djdefi/traincam-ncngrr/ansible/roles/trainview/files/visitor/donate-qr.png

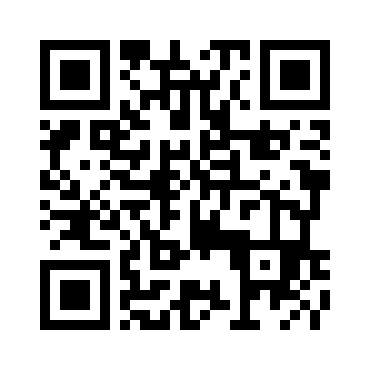
ansible/roles/trainview/files/visitor/donate-qr.png
