djdefi/traincam-ncngrr/ansible/roles/trainview/files/visitor/engine.jpg

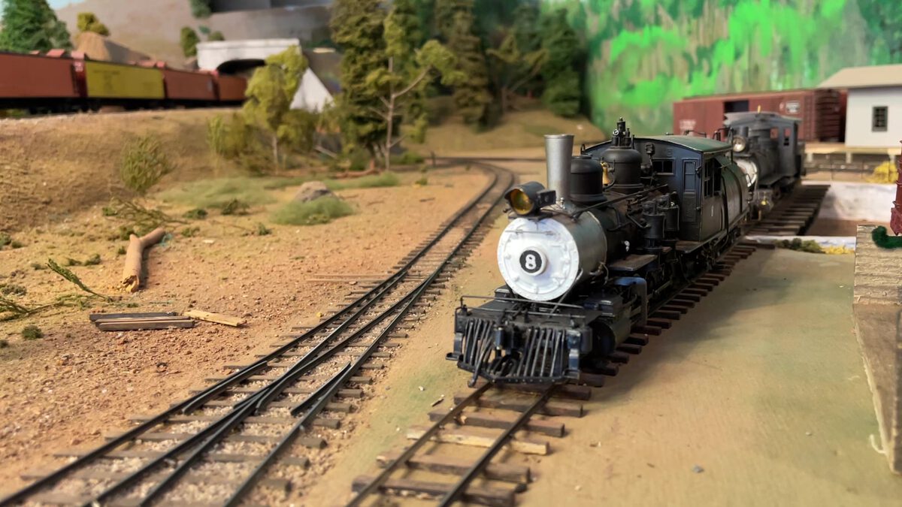
ansible/roles/trainview/files/visitor/engine.jpg
