djdefi/traincam-ncngrr/ansible/roles/trainview/files/visitor/layout.jpg

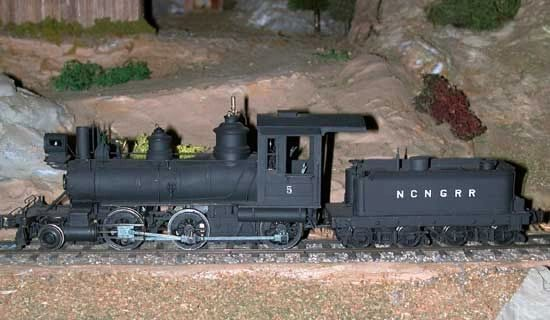
ansible/roles/trainview/files/visitor/layout.jpg
