djdefi/traincam-ncngrr/ansible/roles/trainview/files/visitor/map-qr.png

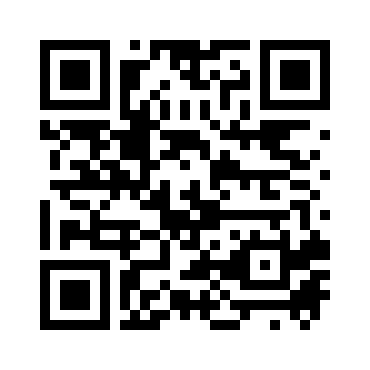
ansible/roles/trainview/files/visitor/map-qr.png
