djdefi/traincam-ncngrr/ansible/roles/trainview/files/visitor/trestle.jpg

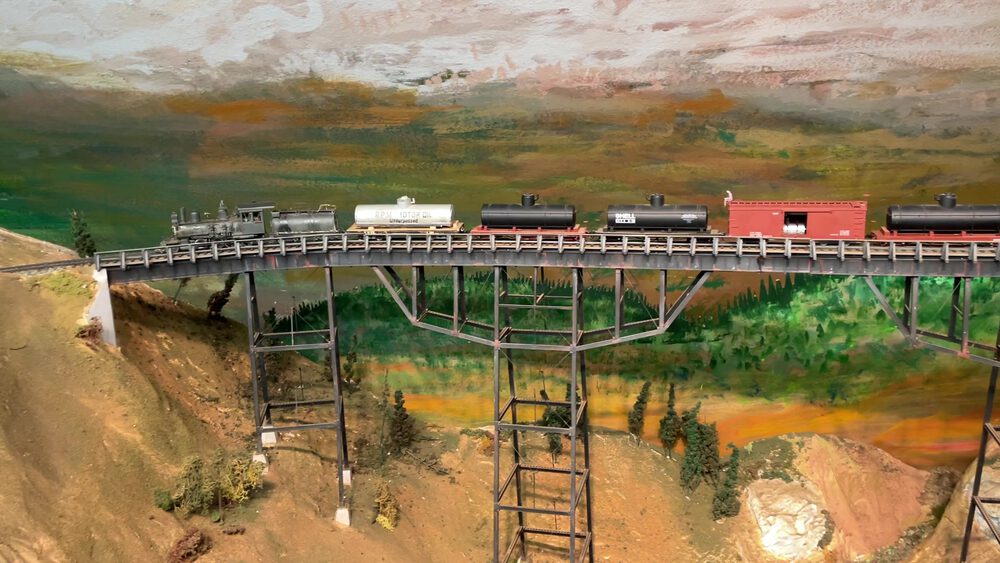
ansible/roles/trainview/files/visitor/trestle.jpg
