djdefi/traincam-ncngrr/ansible/roles/trainview/files/visitor/volunteer-qr.png

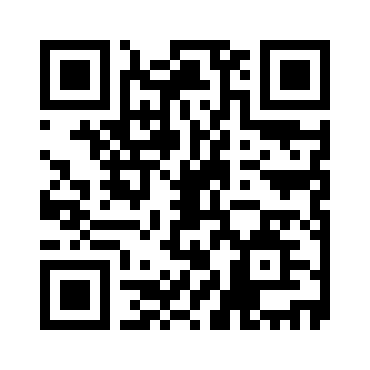
ansible/roles/trainview/files/visitor/volunteer-qr.png
