djdefi/traincam-ncngrr/ansible/roles/trainview/files/visitor/website-qr.png

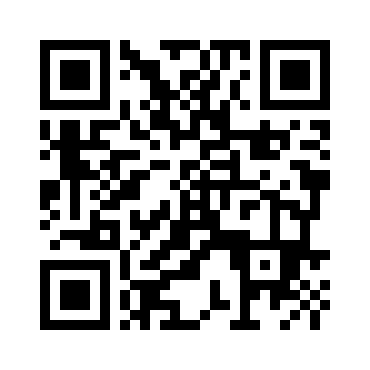
ansible/roles/trainview/files/visitor/website-qr.png
