djdefi/traincam-ncngrr/ios/screenshots/01_camera_list.png

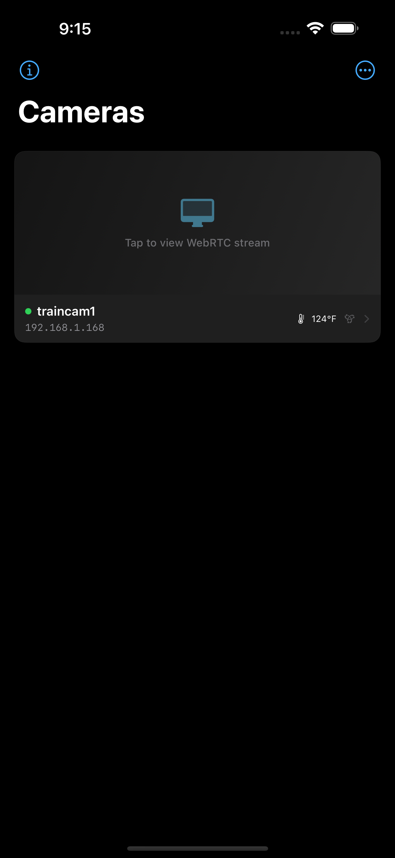
ios/screenshots/01_camera_list.png
