djdefi/traincam-ncngrr/ios/screenshots/02_about.png

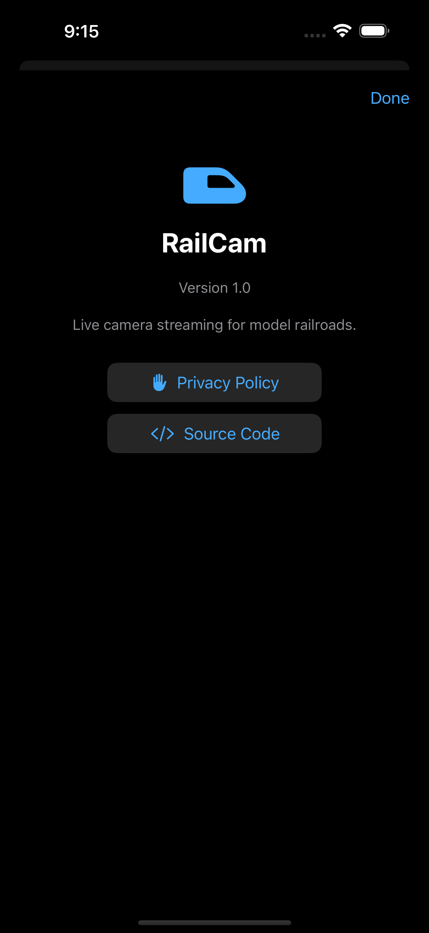
ios/screenshots/02_about.png
