djdefi/traincam-ncngrr/ios/screenshots/03_camera_detail.png

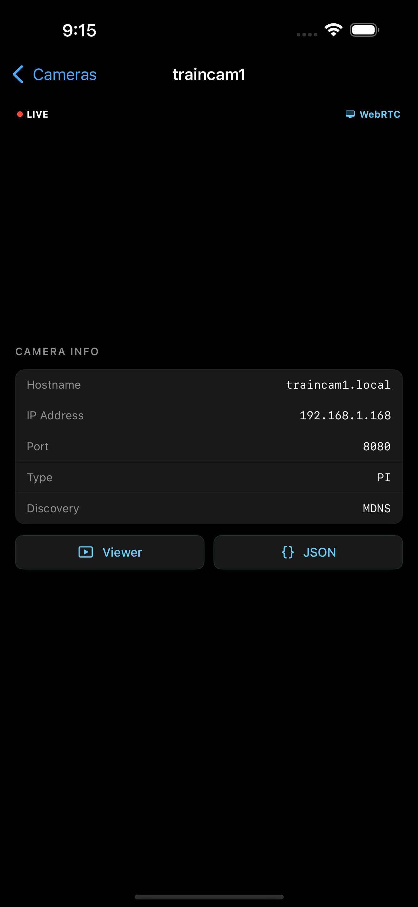
ios/screenshots/03_camera_detail.png
