djdefi/traincam-ncngrr/issues/1.md

### Feature Request: Add mDNS (Bonjour/zeroconf) Service Discovery to ESP32 Camera Server

**Status:** Implemented. Each module advertises `_traincam._tcp` and uses a unique `traincam-xxxxxx.local` hostname.

#### Summary
This issue requests the addition of mDNS (Bonjour/zeroconf) service discovery to the ESP32 camera server.

#### Implementation Details
1. **Initialize mDNS in setup()**: Modify the setup function to initialize mDNS.
2. **Advertise HTTP Service**: Ensure that the HTTP service is advertised over mDNS.
3. **Documentation**: Include brief documentation in the code to guide users on how to utilize this feature.
4. **Reference File**: The implementation can be referenced in the file `camunit/espcameraserver.ino`.

This addition will greatly enhance the usability and accessibility of the ESP32 camera server.
