djdefi/traincam-ncngrr/CameraWebServer/camera_index.h

//File: minimal_index.html.gz, Size: 405
#define index_ov2640_html_gz_len 405
const uint8_t index_ov2640_html_gz[] = {
  0x1f, 0x8b, 0x08, 0x08, 0xc2, 0x61, 0x81, 0x68, 0x00, 0x03, 0x6d, 0x69,
  0x6e, 0x69, 0x6d, 0x61, 0x6c, 0x5f, 0x69, 0x6e, 0x64, 0x65, 0x78, 0x2e,
  0x68, 0x74, 0x6d, 0x6c, 0x00, 0x85, 0x52, 0xcb, 0x6e, 0xc2, 0x30, 0x10,
  0xbc, 0xe7, 0x2b, 0x5c, 0xa3, 0x0a, 0x7a, 0x80, 0x24, 0x54, 0xa5, 0x55,
  0x1e, 0x48, 0x15, 0xa5, 0xd7, 0xa2, 0xd2, 0x4b, 0x4f, 0x95, 0xe3, 0x47,
  0x62, 0xe1, 0xd8, 0x91, 0xed, 0x14, 0x10, 0xe2, 0xdf, 0xeb, 0x90, 0x84,
  0x42, 0x2f, 0x55, 0x0e, 0x23, 0x7b, 0x77, 0x66, 0x77, 0xc6, 0x49, 0x6e,
  0x5e, 0xde, 0x16, 0x1f, 0x9f, 0xab, 0x25, 0x28, 0x6c, 0x29, 0xe6, 0x5e,
  0xd2, 0x03, 0x45, 0xc4, 0x81, 0xe5, 0x56, 0xd0, 0xf9, 0x72, 0xbd, 0xba,
  0x9f, 0x82, 0x05, 0x2a, 0xa9, 0x46, 0x89, 0xdf, 0xde, 0x79, 0x89, 0xb1,
  0xfb, 0x06, 0x33, 0x45, 0xf6, 0x07, 0xa6, 0xa4, 0x1d, 0x33, 0x54, 0x72,
  0xb1, 0x8f, 0x9e, 0x35, 0x47, 0x22, 0x2e, 0x91, 0xce, 0xb9, 0x8c, 0xa6,
  0x41, 0xb5, 0x8b, 0x33, 0x84, 0x37, 0xb9, 0x56, 0xb5, 0x24, 0xd1, 0x80,
  0x05, 0xcd, 0x77, 0xf4, 0x26, 0xd8, 0x51, 0x10, 0x97, 0x54, 0x1f, 0x4a,
  0xb4, 0x1b, 0x6f, 0x39, 0xb1, 0x45, 0x34, 0x0b, 0x9a, 0xf6, 0x8e, 0x1a,
  0x00, 0x54, 0x5b, 0x75, 0x49, 0xde, 0x16, 0xdc, 0xd2, 0xb8, 0x42, 0x84,
  0x70, 0x99, 0x77, 0xd2, 0x4a, 0x13, 0xaa, 0xc7, 0x1a, 0x11, 0x5e, 0x9b,
  0x28, 0x74, 0x57, 0x47, 0x6f, 0x60, 0xac, 0xa6, 0xa8, 0xbc, 0xd0, 0x0d,
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
  0xc4, 0x6f, 0x79, 0xff, 0x08, 0x30, 0x6a, 0x71, 0x31, 0x1a, 0xfa, 0xcc,
  0x15, 0x8b, 0x2f, 0xab, 0xf2, 0x5c, 0xd0, 0xa1, 0x53, 0x79, 0x6d, 0xce,
  0x17, 0x1a, 0x7e, 0xbb, 0x4b, 0x0f, 0x9d, 0x6b, 0xbf, 0xfd, 0xdd, 0x7e,
  0x00, 0x0c, 0x25, 0x39, 0xb4, 0x86, 0x02, 0x00, 0x00
};
