djdefi/traincam-ncngrr/(commit log)

2025-07-16 Open issue requesting mDNS service discovery for ESP32 camera server.
2025-07-21 add cam server
    [partitions.csv]
2026-01-31 Add Ansible playbooks, docs, and test suite for TrainCam
    - Ansible role for Pi deployment (traincam, mediamtx, viewer services)
    - Multi-level architecture docs (simple → contributor)
    - Hardware power chain documentation (DCC → camera)
    - Network/mDNS configuration docs
    - Demo quick reference for meetups
    - Test suite (38 tests for latency, config, network)
    - Scaling guide for multiple cameras
    - WiFi credential management tracked as issue #2
    Viewer URL: http://traincam1.local:8080/viewer.html
    [partitions.csv]
2026-02-01 Production readiness: DRY config, OSS files, CI
    - Add LICENSE (MIT), CONTRIBUTING.md, CODE_OF_CONDUCT.md
    - Add .gitignore for common artifacts
    - Add GitHub Actions CI workflow (lint + test)
    - Add issue/PR templates
    - Consolidate group_vars (remove duplicate ansible/group_vars)
    - Centralize all port numbers in group_vars/traincam.yml
    - Use variables for ports in mediamtx.yml.j2 and tasks
    [main.yml, traincam.yml]
2026-02-12 Add iOS app (RailCam) with App Store submission pipeline
    - iOS app: SwiftUI camera viewer for TrainCam streams (MJPEG + WebRTC)
    - Auto-discovery via mDNS and Bluetooth LE
    - 19 unit tests + 8 UI tests
    - Fastlane automation for App Store Connect
    - Privacy policy, metadata, screenshots
    - App Store display name: RailCam (bundle: com.railcam.app)
2026-02-12 Update app icon: camera lens design
2026-02-12 v1.1: Reliability fixes, onboarding, and settings
    P0 Bug fixes:
    - Persist manually added cameras to UserDefaults
    - WebRTC stream error handling with retry button
    - Telemetry unavailable state UI
    - Fix TelemetryFetcher timer retain cycle
    P1 UX improvements:
    - First-launch onboarding (3-page swipeable guide)
    - Stream health indicator (detect stalled MJPEG streams)
    - Auto-detect camera type for manual IP entry
    - Settings screen (timeout, temp unit, about/privacy links)
2026-02-12 DRY refactor + expand test coverage to 38 tests
    Refactoring:
    - Extract Theme.swift: shared Color.appAccent, .cardBackground, .sectionBackground
    - Extract AppURL constants for privacy policy and source code links
    - Fix force-unwrapped URLs in SettingsView
    - Standardize error messages to 'Stream unavailable'
    New tests (19 added, 38 total):
    - CameraPersistenceTests: Codable roundtrip, UserDefaults storage
    - CameraDiscoveryTests: add/remove/dedupe/sort manual cameras
    - StreamHealthTests: stall detection, error state, lifecycle
2026-02-12 App Store review prep: vibrant icon, strip debug logging, fix placeholders
    - New app icon: bright teal, white camera, clean professional design
    - Wrap all print() in #if DEBUG
    - Fix App Store rating URL (real app ID 6759075304)
    - Add Reset App Data option in Settings (Apple data deletion requirement)
    - Replace emoji with SF Symbol in onboarding
2026-07-28 Prepare TrainCam for fair operation
    Replace the untracked multi-camera viewer with a reproducible single-feed deployment, harden Pi service recovery and mDNS, and prepare the ESP32 firmware for zero-touch discovery.
    Copilot-Session: dcab7405-f2e7-4d6c-9f27-47ca47327750
    [CameraWebServer.ino, app_httpd.cpp, main.yml, traincam.yml]
2026-07-28 Reduce camera Pi power draw
    Run the camera as a strict headless appliance, disable unused hardware and services, and remove a NetworkManager override rejected by the installed version. Preserve WiFi and all video settings.
    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
2026-07-28 Use the NoIR tuning file for the camera module
    The camera has no IR-cut filter, but libcamera was loading the stock
    ov5647.json, which renders the whole scene magenta. Measured on the live
    stream against a neutral 128: U 143.3 / V 148.4 before, 123.9 / 124.8
    after, with luma unchanged at ~97 — it is purely the colour matrix, no
    exposure or noise cost.
    TUNING_FILE is a variable rather than a hardcoded path because an
    IR-filtered module needs the stock tuning instead. A path that does not
    exist warns and falls back to the libcamera default; a colour problem
    should not take the camera offline.
    tests/test_config_parsing.sh evaluates the selection block straight out
    of publish.sh.j2 so the fa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
    [traincam.yml]
2026-07-28 Shorten the AGC shutter ladder so motion stays sharp
    The stock ov5647 tuning is built for stills: exposure_modes.normal walks
    shutter to 30000us before analogue gain passes 4, so a camera bolted to a
    moving train parks at 1/33s and smears everything. Measured 30897us at
    ISO 400 in a daylit office.
    --exposure sport is meant to fix exactly this, but libcamera 0.5.1 ignores
    it -- normal, sport and long all returned 29986us at gain 3.31 on this
    build. (--ev -2 did move it, so the control path itself is live.) That
    leaves patching the ladder in the tuning file as the only route.
    The new ladder spends gain earlier: 15821us at gain 6.00 where stock gave
    29986us at gain 3.06, same scene, same Lux.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
    [main.yml, traincam.yml]
2026-07-28 Reset the Pi from a kernel hang without touching the train
    The camera Pi froze on the bench today: solid ACT LED, no network, dead for
    20+ minutes until power-cycled by hand. Restart=always cannot help here --
    a hung kernel takes systemd with it, so nothing was left running to do the
    restarting. In a train car on a layout that means pulling the car off the
    track mid-show.
    The BCM2835 has a watchdog and systemd can drive it. 14s is not a tuning
    choice: max_hw_heartbeat_ms is WDOG_TICKS_TO_MSECS(PM_WDOG_TIME_SET) =
    0xfffff >> 16 = 15s (drivers/watchdog/bcm2835_wdt.c:29,161-162, rpi-6.12.y,
    matching the 6.12.25 kernel on the Pi). Anything above 15 is silently
    accepted by systemd and then never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
    [main.yml, traincam.yml]
2026-07-28 Recover the camera when the WiFi chip wedges
    The Pi went unreachable three times today and I blamed the battery. The
    persistent journal from 9b6ecdd shows otherwise: it kept logging right up to
    the moment the power was pulled. The Pi was healthy the whole time. Only the
    WiFi was gone.
    21:16:33 brcmf_sdio_txfail: sdio error, abort command and terminate frame
    21:16:34 brcmf_sdio_readframes: RXHEADER FAILED: -110
    21:16:34 brcmf_sdio_isr: failed backplane access
    The SDIO bus to the BCM43430 times out under sustained TX. brcmf_sdio_dpc()
    halts, but only marks the bus down on -ENOMEDIUM, and this is -ETIMEDOUT, so
    it never does. Two consequences shaped this change:
    - wlan0 still reports o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
    [main.yml, traincam.yml]
2026-07-28 Back off and jitter viewer reconnects instead of hammering
    Explains the "143 WHEP sessions in 5 minutes" from the Jul 28 outage, which
    was open in the plan as unexplained. It was not several clients. The journal
    shows every one of those sessions created by the same address AND the same
    source port, 1.57-1.63s apart - AUTOREC_DELAY_MS plus a round trip. One
    browser tab, retrying on a fixed timer while the SDIO radio was already
    failing. MediaMTX holds each dead attempt ~10s before reaping it, so roughly
    six stale sessions existed at any moment, all of them costing server state
    and TX during the exact window the radio could least afford it.
    So: double the delay on each failure, cap at 15s, re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
2026-07-29 Stop spending 38% of the bitrate on keyframes
    ultra_plus means --intra 6, which at 24fps is four keyframes a second. With
    the 2500kbps cap from 6aad60c that turned out to be crippling. Measured on
    the live stream with ffprobe, 8s windows:
    intra 6 38.2% of all bits on keyframes, P avg 9756 B, 2.53 Mbps
    intra 24 17.3%, P avg 11239 B, 2.48 Mbps
    intra 48 11.5%, P avg 11810 B, 2.25 Mbps
    An I-frame averages 28161 B against a P-frame's 10022, so four a second was
    eating the budget that should have been buying picture detail. Switching to
    `low` (intra 24) gives ~15% more bits per P-frame at the same bitrate.
    Confirmed live afterwards: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
2026-07-29 Let the deploy name a camera sensor overlay
    camera_auto_detect=1 only probes the official Raspberry Pi sensors - ov5647,
    imx219, imx477, imx708. Arducam's own boards are not in that list, so an
    Arducam 16MP (imx519) or 64MP (ov64a40) stays completely invisible until the
    overlay is named explicitly, and the symptom is indistinguishable from a dead
    ribbon cable. The on-device overlays README is explicit that these are manual:
    "Load: dtoverlay=imx519,<param>=<val>". This Pi already ships the .dtbo files
    for imx519, ov64a40, imx462/290/327/335/415, imx296, imx477 and imx708.
    Hand-editing /boot/firmware/config.txt is not an option because this role
    manages that file - the next deploy would silen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
2026-07-29 Document why the picture is soft, and how to swap the module
    Two things cost real time this week and neither was written down.
    The fitted OV5647 is a NoIR. 388f808 already fixed the colour matrix for it,
    so the remaining "blurry and washed out" reads like a bitrate or focus
    problem - it is neither. IR floods every photosite (washed out) and focuses
    at a different plane than visible light, landing defocused on top of the
    sharp image (soft). No config setting fixes either; the module is simply the
    wrong part for a lit layout. Added the remote-control trick for telling a
    NoIR from a filtered module, which needs no tools.
    Second, camera_auto_detect probes ONLY ov5647/imx219/imx477/imx708. Ever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
2026-07-29 Patch the AGC ladder on channels[] tuning files too
    The shutter-first AGC ladder from 2cc3555 was only being applied to
    tuning files that put exposure_modes directly in rpi.agc. That is the
    ov5647's schema and nothing else's: imx219, imx477 and imx708 all nest
    one copy per HDR channel under rpi.agc.channels[].
    So fitting an imx219 silently reverted the ladder to stock -
    shutter [100, 10000, 30000, 60000, 66666]
    which parks at 30000us before it will raise gain past 4. That is exactly
    the 1/33s motion smear the ladder exists to prevent, on a camera bolted
    to a moving train. The script did warn on stderr, but a deploy prints
    enough that nobody would have seen it.
    Patches every channel. Th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
2026-07-29 Run the IMX219 module, full FOV, with matching tuning
    The Arducam/"OMP camera v2.3" that "was never detected" is fine. It was
    never a hardware fault: camera_auto_detect only probes the four official
    Raspberry Pi sensors and fails on anything else - including clones of
    those four - in a way indistinguishable from a dead ribbon cable. Named
    explicitly it enumerates first try:
    0 : imx219 [3280x2464 10-bit] (/base/soc/i2c0mux/i2c@1/imx219@10)
    Three changes, each measured on the device:
    camera_auto_detect now follows the overlay. The two must not both run,
    since auto_detect appends its own dtoverlay for whatever it finds. This
    is also what keeps the rollback to one line: clear the overlay an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
    [main.yml, traincam.yml]
2026-07-29 Document the camera swap, and correct the cable advice
    Three fixes to what was written before the module was actually swapped:
    The cable step said to keep the ribbon that works today. That is wrong
    and would have wasted an evening: the Pi Zero end is narrow 22-pin, but
    the module end varies, and the OV5647 here uses narrow->wide 15-pin,
    which physically cannot fit a module with a 22-pin socket. A mismatched
    cable is itself a plausible reason a module "was never detected".
    The NoIR section described the fitted module in the present tense. It is
    no longer fitted. Marked resolved rather than deleted - the symptoms are
    distinctive and worth recognising - and added the reverse case, since
    using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
2026-07-29 Lock AWB gains; retract the "IR-filtered" claim from 5ce4a47
    5ce4a47 said this imx219 is IR-filtered and shipped imx219.json. That was
    wrong, and it was wrong because I judged it by eye from rpicam-jpeg stills.
    Two errors, both caught only by measuring:
    1. THE STILL PATH LIES ABOUT THE VIDEO PATH. rpicam-jpeg and rpicam-vid with
    byte-identical options measured 1.046/1.032 vs 0.785/0.809 on the same
    scene. Every tuning A/B I had run used the still path, so all of them were
    answering a question nobody asked. Measure with `rpicam-vid --codec mjpeg`,
    never rpicam-jpeg, when judging what the stream shows.
    2. Re-run in the video path: imx219.json +61% magenta, imx219_noir.json -21%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
    [traincam.yml]
2026-07-29 Make the venue white balance calibration one command
    The layout is lit by incandescent/halogen flood. Those are blackbody radiators
    - a ~2800K filament puts more power into near-IR than into visible - so a NoIR
    module there is the worst case, and there is no software fix: Bayer dyes are
    largely transparent above ~700nm, so IR lands in R, G and B at similar strength.
    That is a common-mode pedestal and per-channel gains are multiplicative. You
    cannot subtract a common term by multiplying, which is why IR-cut filters are
    hardware.
    A filtered module is on the shopping list but may not arrive, so this makes the
    one thing we CAN control fast and hard to get wrong.
    scripts/calibrate_awb.py replac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
2026-07-29 ESP32 backup camera: survive an AP that is not up yet
    The stock sketch waits for WiFi with an unbounded
    `while (WiFi.status() != WL_CONNECTED) delay(500);`. At a fair everything
    powers on at once, so the AP is routinely not up when the board boots -
    and then setup() never returns and the spare camera is gone for the day.
    It also had no reconnect (loop() was an empty delay(10000)) and no
    watchdog, where the Pi has run RuntimeWatchdogSec=14 since 9b6ecdd.
    Scoped as a STANDALONE spare on its own URL. Not integrated into the
    kiosk: viewer.html.j2 is 139 lines of single-camera WebRTC with zero
    mjpeg handling, so integration is real work, not a free win.
    Verified on the hardware, not just compil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
2026-07-31 docs: battery bank buffering is a requirement, not a given
    ARCHITECTURE.md stated as fact that the bank "buffers the DCC track
    power, keeping the Pi running through dirty track and switch gaps".
    Measured 2026-07-31: pulling the charger input, with the Pi's own cable
    untouched, rebooted the Pi four times out of four. Two of those crashed
    during early boot (journalctl --list-boots shows first entry == last
    entry for boots -3 and -2).
    The bank is not flat and the cells are not absent - the same bank ran
    the Pi for 104 minutes on its cells alone the day before. It is the
    switchover that glitches, which is why the earlier "pass-through
    charging works" result did not catch it: that only ever exer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
2026-08-01 kiosk: serve viewer.html locally on the Pi 5 so a down camera can't wedge it
    viewer.html is served by the camera, so if the camera is down when Chromium
    loads it you get a network error page with no retry logic. Once loaded the
    page reconnects fine on its own, so this only bites at load time -- but the
    camera runs on battery (5.32h measured) and packs get swapped mid-show, so
    "camera absent at load time" is now expected rather than unlucky.
    setup-kiosk.sh keeps a local copy, serves it from localhost, and points it at
    the camera with ?whepBase= (already supported, no viewer change). Adds
    Restart=always and kills the "Restore pages?" bubble that would otherwise sit
    over the video after a powe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
2026-08-01 security: move ESP32 WiFi credentials out of the public repo
    CameraWebServer.ino:16 has carried the traincameranet password in plaintext
    since 806f855, in a repo that is public, under a comment saying "change for
    production". Credentials now come from CameraWebServer/secrets.h, which is
    gitignored, with secrets.h.example as the template.
    test_network_config.sh asserted the SSID *was* hardcoded, so it enforced the
    leak rather than catching it. Replaced with three assertions that guard the
    property we actually want: no hardcoded creds in the .ino, the sketch includes
    secrets.h, and secrets.h is gitignored. That last one matters because without
    the ignore entry the file gets committed silently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
    [CameraWebServer.ino]
2026-08-01 Fix mDNS: disable IPv6 in avahi to stop link-local address churn
    traincam1.local did not resolve at the layout. Root cause measured on the
    device, not guessed: avahi was registering and withdrawing IPv6 temporary
    link-local addresses about once a second, recycling the same addresses. That
    churn made avahi treat its own announcements as a competing claim for the
    host name, so it renamed itself traincam1 -> traincam1-2 -> traincam1-3, and
    the surviving record resolved to 127.0.0.1.
    Every URL in this project uses traincam1.local, so this was load-bearing and
    had nothing to do with the router: unicast was fine (8ms, 0% loss) the whole
    time.
    Verified live before and after:
    before avahi-resol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
    [main.yml]
2026-08-01 Add AWB calibration against a neutral target
    The locked gains in group_vars (0.99,2.23) were measured indoors at home.
    Under the layout lighting they are wrong: a live frame pulled off the RTSP
    stream on 2026-08-01 reads UAVG 131.6 / VAVG 131.1 against a neutral 128,
    i.e. a magenta cast, visible as pink dirt and pink platform decking. That
    understates it, since a frame full of green foliage should pull both the
    other way.
    The script samples the LIVE video path, not a still: per
    group_vars/traincam.yml:39-43 the AWB algorithm converges differently in the
    two pipelines, so a still would calibrate the wrong thing.
    It refuses rather than guesses when the patch is more than 25% off neutral.
    Tha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
2026-08-01 Make the kiosk actually able to reach the camera
    setup-kiosk.sh serves a cached viewer from the kiosk's own localhost so an
    absent camera leaves a retrying page instead of a Chromium error page that
    never retries. It passed ?whepBase= to say where the camera is. The deployed
    viewer never supported ?whepBase=. It derived MediaMTX from window.location
    and swapped the port, so served from the kiosk it looked for the camera at
    http://localhost:8889 and could never connect. The kiosk script has never run
    on hardware, so this was never caught.
    It was invisible because tests/test_network_config.sh asserted "Viewer
    supports WHEP base override" against client/viewer.html, a hand copy that
    does suppo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
2026-08-01 Mirror both kiosk panels, trim boot, pin the AWB tool to the stream's tuning
    Three things from the layout session, each with the check that catches it
    regressing.
    Second display: kanshi puts both HDMI outputs at the same 0,0 origin so labwc
    scans one region out to both connectors - the native compositor mirror, no
    extra service and no second browser. Proven by capturing each output
    separately (grim -o): the two PNGs came back byte-identical. A whole-screen
    grim cannot show this, it composites the logical layout and looks mirrored
    either way, which is how this looked fixed once before while one panel was
    dark.
    Boot: the picture landed minutes after power-on and nothing was slow on its
    own -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
    [traincam.yml]
2026-08-03 Fit the IR-cut module: colour and sharpness were one problem, not two
    An IR-filtered IMX219 replaced the NoIR one. Both symptoms cleared together,
    which is the evidence they shared a cause:
    calibrate_awb.py verify 0.446 bad -> 0.014 good
    ColourTemperature pinned placeholder -> 2915 K, a real reading
    --awb modes no-op -> all 7 work
    the picture salmon-pink and soft -> neutral and sharper
    docs/HARDWARE.md called this before anyone measured it: IR lands in R, G and B
    at similar strength, so it is a common-mode pedestal, and per-channel gains are
    multiplicative - you cannot subtract a common term by multiplying. It also
    predicted the softnes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
    [traincam.yml]
2026-08-03 Fix silent capture race in calibrate_awb
    systemctl stop returns before the sensor fd is released, so verify's
    capture hit "Device or resource busy", produced no frames, and died in
    json.loads with a stack trace instead of saying what went wrong.
    Poll fuser /dev/video0 instead of a fixed sleep (usually one iteration),
    and fail with a readable message when a capture yields nothing.
    Verified against the live camera: verify now returns R/G 1.024 B/G 0.972
    distance 0.053 good, where it previously traceback'd every run.
    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
2026-08-03 docs: meter LiPo pigtails; what to check on a UPS HAT
    JST-PH has no polarity standard - JST specifies the housing and crimps,
    not which pin is positive. The housing is keyed, so a reversed pigtail
    clicks in and feels correct. Measured 2026-08-03: the cell supplied for
    a Waveshare UPS HAT (C) read positive only with the probes swapped, and
    the board got hot on connection. Pi survived clean.
    Also records what a UPS HAT does and does not buy you. It is the right
    class of device where a power bank is not - dynamic path management is
    real switchover, and the INA219 gives live battery state. The things to
    actually check are the pogo-pin mating under vibration and the ~1.8A
    discharge cap, and the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
2026-08-04 ESP32: one stream client no longer blocks the whole HTTP server
    Opening the stream made /status and /control hang indefinitely, and a second
    viewer got nothing at all. esp_http_server services every socket from a single
    task, and the MJPEG handler loops inside it, so the stream starves everything
    else for as long as it runs. Espressif's stock example splits this across two
    httpd instances; the trimmed sketch had lost that.
    Stream stays on :80, diagnostics move to :81. Verified: before, all three
    endpoints blocked >13s; after, :81/status answers in 5.07s while 3.2MB streams
    on :80.
    Also here:
    - /control?framesize=N&quality=N so tuning does not cost a reflash per guess.
    Volatile by design,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
    [CameraWebServer.ino, app_httpd.cpp]
2026-08-04 Viewer: show ESP32 MJPEG, and actually recover when it dies
    ?mjpeg=<url> puts the page in MJPEG mode. The browser is already an MJPEG
    decoder, so this is an <img> and no library. WebRTC was the obvious thing to
    want here and it is not available: the ESP32-S3 has no hardware H.264 encoder
    (esp_h264 guards hw/ behind esp32p4), RFC 7742 s5 will not carry MJPEG, and
    Espressif's own whip_demo caps the S3 at 320x240@10fps. Transcoding on the Pi
    would work but makes the standalone camera depend on the Pi, which deletes the
    redundancy that is the whole reason for having it.
    The recovery I wrote first did not work, and I only found out by testing it.
    Measured in headless Chrome:
    stream cannot be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
2026-08-04 Guard the MJPEG watchdog in the viewer test
    The behavioural proof needs headless Chrome and a fake camera that reboots, so
    it cannot live in CI. These are only deletion guards, but the failure they
    protect against is silent: an MJPEG stream that dies leaves a frozen frame and
    fires no event at all, so a kiosk with the watchdog removed looks fine until
    someone walks up to it.
    Checked they fail when the code is stripped.
    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
2026-08-04 Drop --denoise cdn_off: chroma denoise is worth ~8% of the bitrate
    The flag was never justified. It arrived in ba5b8d0 as scaffold boilerplate
    next to placeholder 640x480@30 defaults, was only moved by 99dcf94, and was
    changed off -> cdn_off inside 4aa081d ("prepare for fair operation") whose
    message never mentions it. The group_vars comment block gives --bitrate and
    --mode a measured paragraph each and is silent on this one.
    cdn_off means luma denoise ON, chroma denoise OFF - and the layout measures
    33-41 lux with the AGC pegged at gain 5.95, which produces exactly the chroma
    speckle cdn_off leaves in.
    Measured with `rpicam-vid --codec mjpeg -q 90`, bytes/frame:
    off 239431 cdn_off 21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
2026-08-04 Stream at 960x540: the encoder is CBR-starved, so fewer pixels get more bits
    The noise complaint is photon starvation, not tuning. Against the real
    production tuning file, AnalogueGain measured 10.24 at 48 lux with
    ExposureTime 41587us against a 41666us frame time - both knobs at their stops,
    and gain PAST the 8.0 last rung of the ladder in group_vars. The layout is
    33-41 lux, darker still.
    Framerate is a real lever (24fps gain 10.24, 15fps 6.56, 12fps 5.95, and
    exposure hard-stops at 73440us so 12fps is the floor) but it pays for noise
    with exactly what 2cc35557 was protecting: that commit chose gain over shutter
    because a moving camera "smears everything" at 1/33s, and 41587us is already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
    [traincam.yml]
2026-08-04 Drop --saturation 1.1: we were amplifying the ugliest noise in the picture
    Boosting chroma boosts chroma noise, and at AnalogueGain 10.24 coloured
    speckle is the dominant artifact. The flag came from 4aa081d ("Prepare
    TrainCam for fair operation") - the same unexplained bundle that silently set
    --denoise cdn_off - with no rationale in the commit message or group_vars.
    Measured as Cb/Cr stddev on a flat dark subject, so the spread is noise rather
    than content:
    sat 1.1 -> 13.80 / 12.74
    sat 1.0 -> 13.19 / 11.74
    sat 0.8 -> 10.66 / 9.61
    Bookended at 1.1 (13.80/12.74 then 13.73/12.88) because the room light drifted
    48 -> 41 lux during the session; the two agree, so the sweep holds.
    Goin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
    [traincam.yml]
2026-08-04 Tell visitors why the picture is gone instead of showing black
    cleanup() has deliberately dropped the last frame since the viewer was
    hardened, because a frozen frame reads as a train that has stopped rather
    than a camera that has gone away. That comment ends "and nobody comes to
    look" - but the replacement was a black screen, which says even less. At a
    public open house that is the thing a visitor sees most often after the
    picture itself.
    So fill it. One overlay, no images to deploy and no carousel: the copy
    explains that the camera rides on the train and takes its power from the
    rails, and that the picture comes back on its own. A failure the public
    understands is not really a failure, an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
2026-08-04 Stop blaming tunnels for dropouts the layout does not have
    The offline card I added in 24b57f4 told visitors the picture "drops out in
    tunnels and behind scenery". Nothing measured that. I wrote it because it
    sounded like something a train camera would do, which is exactly the kind of
    plausible-but-unwalked claim this project keeps having to retract - and this
    one would have been on a screen in front of the public all week.
    The dropout we have actually observed is WiFi: wlan0 lost association for 77s
    at the layout on 2026-08-01 (NetworkManager 'ssid-not-found', already cited
    above the stall watchdog), plus the SDIO wedge in docs/NETWORK.md. So the copy
    now names the WiFi and the power arran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
2026-08-05 A saved hotspot outranked the layout network the whole time
    The camera's iphone-hotspot profile was autoconnect=yes at priority 10, against
    5 for the layout network. Any time that hotspot was switched on nearby, the Pi
    would have walked off the layout network mid-run and the kiosk would have gone
    black - with nothing in any log saying so, because the Pi is still online, just
    somewhere useless.
    Found by fieldcheck.sh, which prints the priority table for exactly this reason
    and which I had never actually read past the SSID line.
    Disarmed on the Pi with `nmcli con mod iphone-hotspot connection.autoconnect no`
    (persisted to /etc/NetworkManager/system-connections, survives reboot). Ansible
    does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
2026-09-29 Recover stalled kiosk capture and show offline visitor information
    Bring the existing trainview role into the main-based branch, include the deployed browser watchdog, and close USB capture stalls with bounded complete-frame reads and process termination. Select camera feeds by fresh viewer frames, keep USB on its own display, and show local layout photos and verified website QR codes during fallback. Include provisioning, recovery tests, and operating limits.
    [main.yml]
2026-09-29 Make kiosk signage readable and put USB on the larger display
    Keep content inside overscan-safe margins, fit camera frames without cropping, simplify visitor slides into large bold signs, and verify all slide layouts at HD and SD sizes. Assign USB to HDMI-A-1 and train/visitor content to HDMI-A-2, matching the arrangement confirmed at the layout.
